NachuT/Thinnest-Cube-Timer/README.md

# Thinnest-Cube-Timer
## The worlds thinnest cube timer with capacitive touch sensing
Screenshot 2026-06-12 at 11 31 15 PM

Here are some more details! :
- USB-C powered and for data + firmware upload
- Uses 2 capacative touch ICs conencted to large copper pads
- RP2040 with Flash and Crystal embedded
- Buttons for input and oled+leds for outputs

Please feel free to view my journal to see how I went about this project or production for the gerbers to produce it yourself.

### Schematic: 

Screenshot 2026-06-12 at 11 34 41 PM

### PCB: 

Screenshot 2026-06-12 at 11 35 09 PM

### PCB but the actual compnents: 

Screenshot 2026-06-12 at 11 35 53 PM
