NachuT/Thinnest-Cube-Timer/bom.csv

Item | Price | Store Buying From | Shipping | Total Price | Full Total
PCB | 45.17 | JLC PCB | 22.01 | 67.18 | 67.18
Oled Screen | 5.22 | Aliexpress | 3.6 | 8.82 | 76.0
