NachuT/Thinnest-Cube-Timer/Production/BOM_Board1_PCB1_2026-06-12.csv

Item # | Quantity per board | Comment | Reference designators | Footprint | Value | Manufacturer Part | Manufacturer | Supplier Part | Supplier | Unique ID | Pin Count | Category | LCSC Stock | LCSC Price | JLCPCB Stock | JLCPCB Price | Layer | Mounting Style | Add into BOM | Convert to PCB | 3D Model Title | Device | Name | 3D Model Transform | JLCPCB Part Class | Description | sourceId | spicePre
1 | 1 | 22uF | C1 | C0603 | 22uF | CL10A226MQ8NRNC | SAMSUNG(三星) | C59461 | LCSC | gge65 | 2 | Capacitors:Multilayer Ceramic Capacitors MLCC - SMD/SMT |  |  | 1364014 | 0.0034 | T | SMT | yes |  | C0603_L1.6-W0.8-H0.8 | CL10A226MQ8NRNC | 22uF | 62.992,31.496,0,0,0,0,0,0,0 | Basic Part | Capacitance:22uF Tolerance:±20% Tolerance:±20% Voltage Rating:6.3V Temperature Coefficient:X5R
2 | 14 | 100nF | C2,C3,C5,C6,C7,C8,C9,C10,C11,C14,C17,C18,C20,C22 | C0402 | 100nF | CL05B104KO5NNNC | SAMSUNG(三星) | C1525 | LCSC | gge7,gge8,gge10,gge10_0,gge11,gge12,gge13,gge14,gge15,gge16,gge30,gge40,gge42,gge48 | 2 | Capacitors:Multilayer Ceramic Capacitors MLCC - SMD/SMT |  |  | 13974133 | 0.0004 | T | SMT | yes |  | C0402_L1.0-W0.5-H0.5 | CL05B104KO5NNNC | 100nF | 39.37,19.685,0,0,0,0,0,0,0 | Basic Part | Capacitance:100nF Tolerance:±10% Tolerance:±10% Voltage Rating:16V Temperature Coefficient:X7R
3 | 2 | 10uF | C4,C23 | C0402 | 10uF | CL05A106MQ5NUNC | SAMSUNG(三星) | C15525 | LCSC | gge66,gge66_0 | 2 | Capacitors:Multilayer Ceramic Capacitors MLCC - SMD/SMT |  |  | 2033850 | 0.0028 | T | SMT | yes |  | C0402_L1.0-W0.5-H0.5 | CL05A106MQ5NUNC | 10uF | 39.37,19.685,0,0,0,0,0,0,0 | Basic Part | Capacitance:10uF Tolerance:±20% Tolerance:±20% Voltage Rating:6.3V Temperature Coefficient:X5R
4 | 2 | 15pF | C12,C13 | C0402 | 15pF | 0402CG150J500NT | FH(风华) | C1548 | LCSC | gge18,gge19 | 2 | Capacitors:Multilayer Ceramic Capacitors MLCC - SMD/SMT |  |  | 693912 | 0.0004 | T | SMT | yes |  | C0402_L1.0-W0.5-H0.5 | 0402CG150J500NT | 15pF | 39.37,19.685,0,0,0,0,0,0,0 | Basic Part | Capacitance:15pF Tolerance:±5% Tolerance:±5% Voltage Rating:50V Temperature Coefficient:C0G
5 | 2 | 1uF | C15,C16 | C0402 | 1uF | CL05A105KA5NQNC | SAMSUNG(三星) | C52923 | LCSC | gge67,gge68 | 2 | Capacitors:Multilayer Ceramic Capacitors MLCC - SMD/SMT |  |  | 3437129 | 0.0011 | T | SMT | yes |  | C0402_L1.0-W0.5-H0.5 | CL05A105KA5NQNC | 1uF | 39.37,19.685,0,0,0,0,0,0,0 | Basic Part | Capacitance:1uF Tolerance:±10% Tolerance:±10% Voltage Rating:25V Temperature Coefficient:X5R
6 | 2 | 4.7nF | C19,C21 | C0402 | 4.7nF | 0402B472K500NT | FH(风华) | C1538 | LCSC | gge43,gge49 | 2 | Capacitors:Multilayer Ceramic Capacitors MLCC - SMD/SMT |  |  | 1213716 | 0.0007 | T | SMT | yes |  | C0402_L1.0-W0.5-H0.5 | 0402B472K500NT | 4.7nF | 39.37,19.685,0,0,0,0,0,0,0 | Basic Part | Capacitance:4.7nF Tolerance:±10% Tolerance:±10% Voltage Rating:50V Temperature Coefficient:X7R
7 | 1 | KT-0603R | LED1 | LED-SMD_L1.6-W0.8-R-RD |  | KT-0603R | KENTO | C2286 | LCSC | gge36 | 2 | Optoelectronics:LED Indication - Discrete |  |  | 7833374 | 0.0011 | T | SMT | yes |  | LED0603_L1.6-W0.8-H0.6 | KT-0603R | KT-0603R | 63.7794,31.496,0,0,0,0,-4.528,0,0 | Basic Part | Lamp Holder Type:1.6mm x 0.8mm square LED Illumination Color:Red Voltage - Forward(Vf):1.8V~2.4V Voltage - Forward(Vf):1.8V~2.4V Power(Watts):40mW Forward Current:20mA Wavelength - Dominant:615nm~630nm Wavelength - Dominant:615nm~630nm Peak Wavelength:645
8 | 1 | KT-0805G | LED2 | LED0805-R-RD |  | KT-0805G | KENTO | C2297 | LCSC | gge37 | 2 | Optoelectronics:LED Indication - Discrete |  |  | 3016969 | 0.0025 | T | SMT | yes |  | LED0805-RD | KT-0805G | KT-0805G | 79.527,49.2125,0,0,0,0,0,0,0 | Basic Part | Lamp Holder Type:2mm x 1.25mm square LED Illumination Color:Emerald Green Voltage - Forward(Vf):2.6V~3.1V Voltage - Forward(Vf):2.6V~3.1V Power(Watts):100mW Forward Current:5mA Wavelength - Dominant:513nm~528nm Wavelength - Dominant:513nm~528nm Peak Wavel
9 | 1 | HS91L02W2C01 | OLED2 | OLED-TH_L38.0-W12.0_HS91L02W2C01 |  | HS91L02W2C01 | HS(汉昇) | C5248081 | LCSC | gge1 | 4 | Displays:OLED Display |  |  | 3580 | 0.3449 | T | DIP | yes |  | OLED-TH_L38.0-W12.0_HS91L02W2C01 | HS91L02W2C01 | HS91L02W2C01 | 1496.06,472.44,0,0,0,0,688.975,0,0 | Extended Part | Controller Type:SSD1306 chip Interface:I2C Size:0.91 Dot Pixels:128x32 Operating Temperature:- Operating Temperature:- Type of Drive:Passive (PMOLED) Display Range:22.384x5.584mm Display Color:White Luminance:150cd/m2 Function:- Quiescent Current:- Voltag
10 | 2 | 10kΩ | R1,R8 | R0402 | 10kΩ | 0402WGF1002TCE | UNI-ROYAL(厚声) | C25744 | LCSC | gge61,gge62 | 2 | Resistors:Chip Resistor - Surface Mount |  |  | 3571433 | 0.0005 | T | SMT | yes |  | R0402_L1.0-W0.5-H0.4 | 0402WGF1002TCE | 10kΩ | 39.37,19.685,0,0,0,0,0,0,0 | Basic Part | Type:Thick Film Resistor Resistance:10kΩ Tolerance:±1% Tolerance:±1% Power(Watts):62.5mW Voltage-Supply(Max):50V Temperature Coefficient:±100ppm/℃ Temperature Coefficient:±100ppm/℃ Operating Temperature:-55℃~+155℃ Operating Temperature:-55℃~+155℃
11 | 2 | 330Ω | R2,R5 | R0402 | 330Ω | 0402WGF3300TCE | UNI-ROYAL(厚声) | C25104 | LCSC | gge57,gge58 | 2 | Resistors:Chip Resistor - Surface Mount |  |  | 1148121 | 0.0002 | T | SMT | yes |  | R0402_L1.0-W0.5-H0.4 | 0402WGF3300TCE | 330Ω | 39.37,19.685,0,0,0,0,0,0,0 | Basic Part | Type:Thick Film Resistors Resistance:330Ω Tolerance:±1% Tolerance:±1% Power(Watts):1/16W Voltage-Supply(Max):50V Temperature Coefficient:±100ppm/℃ Temperature Coefficient:±100ppm/℃ Operating Temperature:-55℃~+155℃ Operating Temperature:-55℃~+155℃
12 | 2 | 27.4Ω | R3,R4 | R0402 | 27.4Ω | WR04X27R4FTL | Walsin(华新科) | C172043 | LCSC | gge71,gge72 | 2 | Resistors:Chip Resistor - Surface Mount |  |  | 9374 | 0.0002 | T | SMT | yes |  | R0402_L1.0-W0.5-H0.4 | WR04X27R4FTL | 27.4Ω | 39.37,19.685,0,0,0,0,0,0,0 | Extended Part | Type:Thick Film Resistor Resistance:27.4Ω Tolerance:±1% Tolerance:±1% Power(Watts):62.5mW Voltage-Supply(Max):50V Temperature Coefficient:±100ppm/℃ Temperature Coefficient:±100ppm/℃ Operating Temperature:-55℃~+155℃ Operating Temperature:-55℃~+155℃
13 | 2 | 1kΩ | R6,R7 | R0402 | 1kΩ | 0402WGF1001TCE | UNI-ROYAL(厚声) | C11702 | LCSC | gge59,gge60 | 2 | Resistors:Chip Resistor - Surface Mount |  |  | 4276671 | 0.0002 | T | SMT | yes |  | R0402_L1.0-W0.5-H0.4 | 0402WGF1001TCE | 1kΩ | 39.37,19.685,0,0,0,0,0,0,0 | Basic Part | Type:Thick Film Resistor Resistance:1kΩ Tolerance:±1% Tolerance:±1% Power(Watts):62.5mW Voltage-Supply(Max):50V Temperature Coefficient:±100ppm/℃ Temperature Coefficient:±100ppm/℃ Operating Temperature:-55℃~+155℃ Operating Temperature:-55℃~+155℃
14 | 4 | 4.7kΩ | R9,R10,R11,R12 | R0402 | 4.7kΩ | 0402WGF4701TCE | UNI-ROYAL(厚声) | C25900 | LCSC | gge63,gge64,gge64_0,gge64_1 | 2 | Resistors:Chip Resistor - Surface Mount |  |  | 4824857 | 0.0002 | T | SMT | yes |  | R0402_L1.0-W0.5-H0.4 | 0402WGF4701TCE | 4.7kΩ | 39.37,19.685,0,0,0,0,0,0,0 | Basic Part | Type:Thick Film Resistor Resistance:4.7kΩ Tolerance:±1% Tolerance:±1% Power(Watts):62.5mW Voltage-Supply(Max):50V Temperature Coefficient:±100ppm/℃ Temperature Coefficient:±100ppm/℃ Operating Temperature:-55℃~+155℃ Operating Temperature:-55℃~+155℃
15 | 2 | 5.1kΩ | R15,R16 | R0402 | 5.1kΩ | 0402WGF5101TCE | UNI-ROYAL(厚声) | C25905 | LCSC | gge69,gge70 | 2 | Resistors:Chip Resistor - Surface Mount |  |  | 2679213 | 0.0002 | T | SMT | yes |  | R0402_L1.0-W0.5-H0.4 | 0402WGF5101TCE | 5.1kΩ | 39.37,19.685,0,0,0,0,0,0,0 | Basic Part | Type:Thick Film Resistor Resistance:5.1kΩ Tolerance:±1% Tolerance:±1% Power(Watts):62.5mW Voltage-Supply(Max):50V Temperature Coefficient:±100ppm/℃ Temperature Coefficient:±100ppm/℃ Operating Temperature:-55℃~+155℃ Operating Temperature:-55℃~+155℃
16 | 4 | TS-1088-AR02016 | SW1,SW2,SW3,SW4 | SW-SMD_L3.9-W3.0-P4.45 |  | TS-1088-AR02016 | XUNPU(讯普) | C720477 | LCSC | gge27,gge35,gge38,gge39 | 2 | Switches:Tactile Switches |  |  | 761054 | 0.0083 | T | SMT | yes |  | SW-SMD_L3.9-W2.9-H2.0-LS4.8 | TS-1088-AR02016 | TS-1088-AR02016 | 188.976,114.174,0,0,0,0,0,0,0 | Basic Part | Circuit:SPST Actuator Style:Round Button Operating Force:1.6N Mounting Type:Surface Mount,Vertical Length:4mm Width:3mm Switch Height:2mm with Bracket:Without Bracket Contact Current:50mA Voltage Rating:12V Actuator/Cap Color:Black Termination Style:SMD(S
17 | 1 | RP2040 | U1 | LQFN-56_L7.0-W7.0-P0.4-EP |  | RP2040 | Raspberry Pi(树莓派) | C2040 | LCSC | gge2 | 57 | Embedded Processors & Controllers:Microcontrollers (MCU/MPU/SOC) |  |  | 44269 | 0.1471 | T | SMT | yes |  | LQFN-56_L7.0-W7.0-P0.4-EP | RP2040_C2040 | RP2040 | 276.377,276.377,0,0,0,0,0,0,0 | Extended Part | CPU Core:- CPU Maximum Speed:133MHz Number of I/O:30 ADC (Bit):12bit
18 | 2 | AT42QT1010-TSHR | U2,U3 | SOT-23-6_L2.9-W1.6-P0.95-LS2.8-BR |  | AT42QT1010-TSHR | MICROCHIP(美国微芯) | C74512 | LCSC | gge3,gge47 | 6 | Sensors:Touch Sensors |  |  | 3871 | 0.1955 | T | SMT | yes |  | SOT-23-6_L2.9-W1.6-H1.5-LS2.8-P0.95 | AT42QT1010-TSHR | AT42QT1010-TSHR | 110.73671,114.173,0,180,0,0,0.001,-0.003,0 | Extended Part | Number of Channels:1 Voltage - Supply:1.8V~5.5V Voltage - Supply:1.8V~5.5V Current - Supply:729uA Operating Temperature:-40℃~+85℃ Operating Temperature:-40℃~+85℃ Standby Current:16.5uA
19 | 1 | W25Q128JVSIQ | U4 | SOIC-8_L5.3-W5.3-P1.27-LS8.0-BL |  | W25Q128JVSIQ | Winbond(华邦) | C97521 | LCSC | gge4 | 8 | Memory:NOR FLASH |  |  | 110959 | 0.5283 | T | SMT | yes |  | SOIC-8_L5.3-W5.3-H1.9-LS7.9-P1.27 | W25Q128JVSIQ | W25Q128JVSIQ | 208.661,311.25654,0,0,0,0,-0.0005,0.0005,0 | Basic Part | Interface:SPI Memory Size:128Mbit Clock Frequency:133MHz Voltage - Supply:2.7V~3.6V Voltage - Supply:2.7V~3.6V Standby Supply Current:1uA Program / Erase Cycles:100,000 Cycles Page Programming Time (Tpp):3ms Block Erase Time(tBE):120ms@(32KB) Data Retenti
20 | 1 | 12MHz | U5 | CRYSTAL-SMD_4P-L3.2-W2.5-BL | 12MHz | ABM8-272-T3 | ABRACON | C20625731 | LCSC | gge17 | 4 | Crystals, Oscillators, Resonators:Crystals |  |  | 18494 | 0.0438 | T | SMT | yes |  | CRYSTAL-SMD_4P-L3.2-W2.5-BL | ABM8-272-T3_C20625731 | 12MHz | 125.984,98.425,0,0,0,0,0,0,0 | Extended Part | Type:Crystal Oscillator Frequency:12MHz Normal temperature Frequency Tolerance:±30ppm Normal temperature Frequency Tolerance:±30ppm Load Capacitance:10pF Frequency Stability:±30ppm Frequency Stability:±30ppm Equivalent Series Resistance(ESR):50Ω Operating
21 | 1 | AMS1117-3.3 | U6 | SOT-223-3_L6.5-W3.4-P2.30-LS7.0-BR |  | AMS1117-3.3 | Advanced Monolithic Systems | C6186 | LCSC | gge31 | 4 | Power Management (PMIC):Voltage Regulators - Linear, Low Drop Out (LDO) Regulators |  |  | 1881901 | 0.0295 | T | SMT | yes |  | SOT-223-4P_L6.5-W3.5-H1.6-LS7.0-P2.30 | AMS1117-3.3_C6186 | AMS1117-3.3 | 279.89794,255.905,0,180,0,0,-3.9385,-0.0005,0 | Basic Part | Output Configuration:Positive Voltage - Supply:15V Output Voltage:3.3V Output Voltage:3.3V Output Current:1A Power Supply Rejection Ratio (PSRR):72dB@(120Hz) Voltage Dropout:1.1V@(800mA) standby current:5mA Noise:0.003%Vout Features:Short Circuit Protecti
22 | 1 | TYPE-C-31-M-12 | USBC1 | USB-C_SMD-TYPE-C-31-M-12_1 |  | TYPE-C-31-M-12 | 韩国韩荣 | C165948 | LCSC | gge5 | 16 | Connectors:USB Connectors |  |  | 185891 | 0.0275 | T | DIP | yes |  | USB-C_SMD-TYPE-C-31-M-12_1 | TYPE-C-31-M-12 | TYPE-C-31-M-12 | 351.9678,311.023,0,180,0,0,0,-43.307,-33.465 | Extended Part | Connector Type:Type-C Protocol Standard:- Gender:Female Mounting Type:Surface Mount, Right Angle Number of Contacts:16P Number of Ports:1 Current Rating-Power:5A Voltage Rating:20V Connect-Disconnect Life:10,000 cycles Length:7.35mm Operating Temperature:
