NachuT/Thinnest-Cube-Timer/PCB/SCH_Schematic1_2026-06-12.pdf

# QSPI_SD3 51 DVDD ⁵⁰

# USB

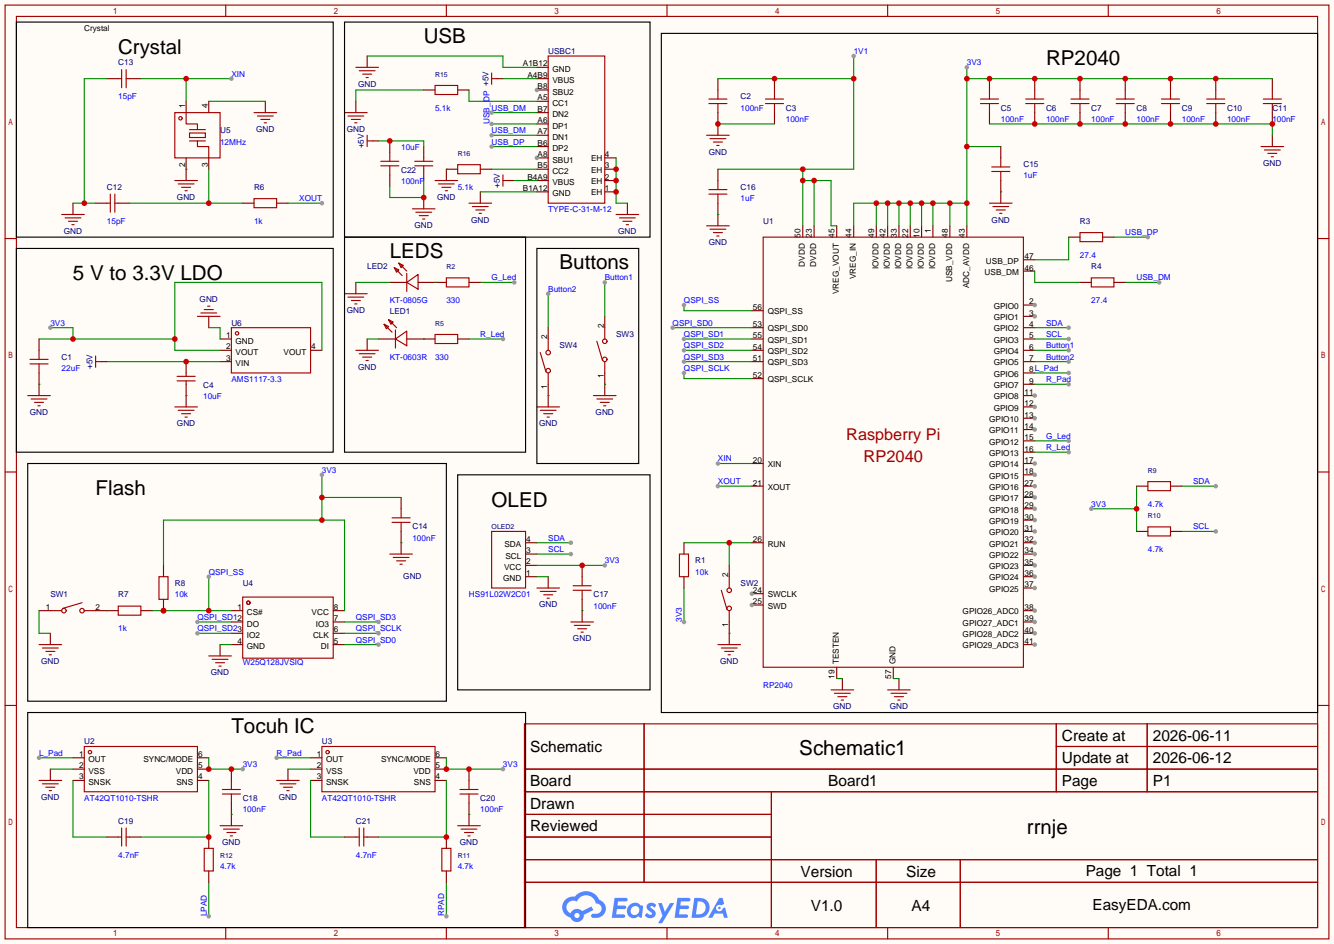
[picture p1: page 1]

Schematic | Schematic1 | Create at | 2026-06-11

Update at | 2026-06-12

Board | Board1 | Page | P1
Drawn | | rrnje
Reviewed

Version | Size | Page 1 Total 1
V1.0 | A4 | EasyEDA.com
