NachuT/Thinnest-Cube-Timer/(list of files, drawings)

Other design files:
PCB/ProPrj_rrnje_2026-06-12.epro
