NachuT/Thinnest-Cube-Timer/Journal.md

<!--
  This journal is auto generated by Stasis.
-->

# 6/13/2026 6 AM - Finished the Pad

_Time spent: 2h_

Screenshot 2026-06-12 at 10.04.23 PM

Screenshot 2026-06-12 at 10.04.42 PM

To come to this result first I had to create the Cubing legal  timer desgin which I got by saving a image of the timer and then putting it into a tool called vectorize.ai that gave a image with just the black borders of the timer which I screenshotted and put into a png to dxf converter. Then I just imported the dxf and tweaked around with the scaling until it was scaled correctly. After this I just positioned my board in the thing and placed the copper regions. It took me a while to figure out the copper regions because unless you already have a trace there it doesnt generate the region for some reason. Also getting the shape right for the region required copying and pasting specific parts of the outline only and closing them off with a line. Lastly I also added a soldermask exclusion zone to make the pads sensitive and just copied this entire right side assembly to the left to create 2 pads.




# 6/13/2026 3 AM - PCB Main part Done

_Time spent: 6h_

Wow. That routing was painfully annoying and kind of satisfying to do but definitely a lot harder than I thought. First what I did was make a rough outline of what the boards components would look like without passives as shown below. (the image below has like 4 capacitors in it but you get the point)
Screenshot 2026-06-11 at 5.57.14 PM
After this I logically put in all of the passives really close to where they needed to be for obvious reasons but then quickly ran into a sizing problem as I had components with massive packages for no reason but thats what I found first. To fix this I went into the scematic and changed a lot of compents to smd 402. FInally then it looked like everything fit until I got to the flash. The flash was such a pain because routing it normally with passives around it made the QSPI pins have 20mm differences in length which is horrible. I then deleted everything and started off with the flash which led to decoupling capacitors being a whole centimeter from their pin. I also asked for a lot of help from ppl in slack and the ee discord server and I am thankful for evryone who helped. I then once again delted and found a solution where I put the flash at a 45 degree tilt and I was just able to squeeze everything. But then I realized that my diferential pair on the USB was horrible so I also rerouted that entire section once again to get better differential pairs. From here the routing wasn't too eventful I just moved around traces and compnents as I saw fit and placed 2 ground planes which I stitched together with vias to prevent islands. I also ended up using a lot of vias for signal gpio pins throughout the board. Lastly I just added some cool silkscreen to finish the main part of the baord.
Screenshot 2026-06-12 at 8.54.15 PM

Screenshot 2026-06-12 at 8.54.48 PM





# 6/11/2026 11 PM - Finished Schematic

_Time spent: 2h_

I fixed some slight resistor errors I had while doing the project late at night and also then wired up the rest of the GPIO which was mostly straightforward however I had to do some calculation for the touch ICs so they arent insanely sensitive but they are still going to detect my hands. I also then tied their mode to high so that they are in fast mode which is delay up to 1ms which is great.
Screenshot 2026-06-11 at 4.24.38 PM



# 6/11/2026 8 AM - Base of the RP2040

_Time spent: 4h_

Screenshot 2026-06-11 at 1.12.18 AM
It was really tedious connecting everything together since easyeda is kind of trash too making a lot of the schematic look super unclean but I think I have the basics down for a RP2040 device with USB power and programming, The only thing I am worried about is I double checked this a lot but I am still not sure if I mightve used a incorrect resistor or smth like that. It also took a lot of time to find JLCPCB basic parts as well which is why sometimes I use series resistors on purpose to achieve values.



# 6/10/2026 11 PM - Research

_Time spent: 3h_

I just set a 3 hour timer to make sure I really had everything set that I needed to do the project. First, I went with the RP2040 as that chip that i foujnd has the easiest to understand documentation. This was especially helpful https://pip-assets.raspberrypi.com/categories/814-rp2040/documents/RP-008279-DS-1-hardware-design-with-rp2040.pdf. I also did researh on the touch ICs i would be using as well as more information on how my USB for this could be used for Power, Boot, as well as to act as a spacebar. I also planned out for the LCD to solder it myself but put a slot cut through the board so those passives on the back dont interfere it from being flat on the board.

Screenshot 2026-06-10 at 4.30.48 PM
