NachuT/Thinnest-Cube-Timer/(commit log)

2026-06-13 Add journal entries for RP2040 project progress
    Documented the progress and challenges faced while designing the PCB and schematic for an RP2040 device, including time spent on various tasks.
2026-06-13 Enhance README with schematic and PCB images
    Added additional details and images for schematic, PCB, and components.
2026-06-13 all the files
    [BOM_Board1_PCB1_2026-06-12.csv, PickAndPlace_PCB1_2026_06_12.xlsx, ProPrj_rrnje_2026-06-12.epro]
2026-06-16 Add BOM CSV with item details and pricing
    [bom.csv]
